MagdaNastase/Stabilizator-de-tensiune-cu-ERS/README.md

I designed and implemented a voltage stabilizer with a series regulator (ERS), ensuring a stable output voltage and overload protection. The project included simulations, PCB design, and functionality testing.
