MagdaNastase/Stabilizator-de-tensiune-cu-ERS/P1_2024_434D_Nastase_Maria-Magdalena_SERS_N17_Pspice/Proiect docs/proiect_CEF2.pdf

Facultatea de Electronică, Telecomunicații și Tehnologia Informației

## Proiect - Circuite electronice fundamentale 2

## Stabilizator de tensiune cu ERS

### Student: Năstase Maria-Magdalena

### Grupa: 434D

## CUPRINS

### 1. Date inițiale de proiectare

### 2. Schema bloc a montajului electric

### 3. Schema electrică a montajului

### 4. Simulări efectuate pentru a demonstra funcționarea schemei în parametrii impuși

### 1. Date inițiale de proiectare

Să se proiecteze și realizeze un stabilizator de tensiune cu ERS având următoarele caracteristici:

¨ Tensiunea de ieșire reglabilă în intervalul:
- 8. 5 ÷ 17 [V] pentru N=17
¨ Element de reglaj serie;
¨ Sarcina la ieșire 680[Ω];
¨ Deriva termică < 2mV/⁰C;
¨ Protecție la suprasarcină prin limitarea temperaturii tranzistorului regulator serie la120⁰C, si a curentului maxim la 0,5A;
¨ Tensiune de intrare în intervalul:
- 30,6 ÷ 34 pentru N=17
¨ Amplificarea | în | tensiune | minimă | (în | buclă | deschisă) | a
amplificatorului de eroare:minim 100;
¨ Domeniul temperaturilor de funcționare: 0

0

-60⁰C (verificabil
prin testare întemperatură);
¨ Semnalizarea prezenței tensiunilor de intrare/ieșire cu diodă de tip LED.

### 2. Schema bloc a montajului electric

Se utilizează o schemă de stabilizator cu element regulator serie (Reg) comandat de un amplificator de eroare (a) care compară tensiunea dată de referinţa de tensiune (Ref) cu tensiunea preluată de la ieşire prin reţeaua de reacţie. La acesta se adaugă un circuit de protecţie la suprasarcină(Prot)

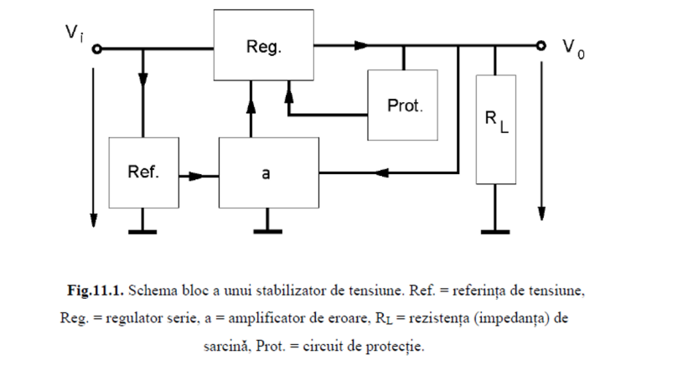
[picture p2: figure]

La intrarea neinversoare a amplificatorului de eroare se aplică tensiunea de referinţă, oferită de blocul REF. La intrarea inversoare a amplificatorului de eroare AE se aplică, prin intermediul reacţiei negative, o fracţiune din tensiunea de ieşire. Blocul de regulator serie ERS este comandat de amplificatorul de eroare care compară tensiunea dată de referinţa de tensiune REF cu tensiunea preluată de la ieşire prin reţeaua de reacţie. La acesta se adaugă un circuit de protecţie la suprasarcină Prot.

### 3. Schema electrică a montajului

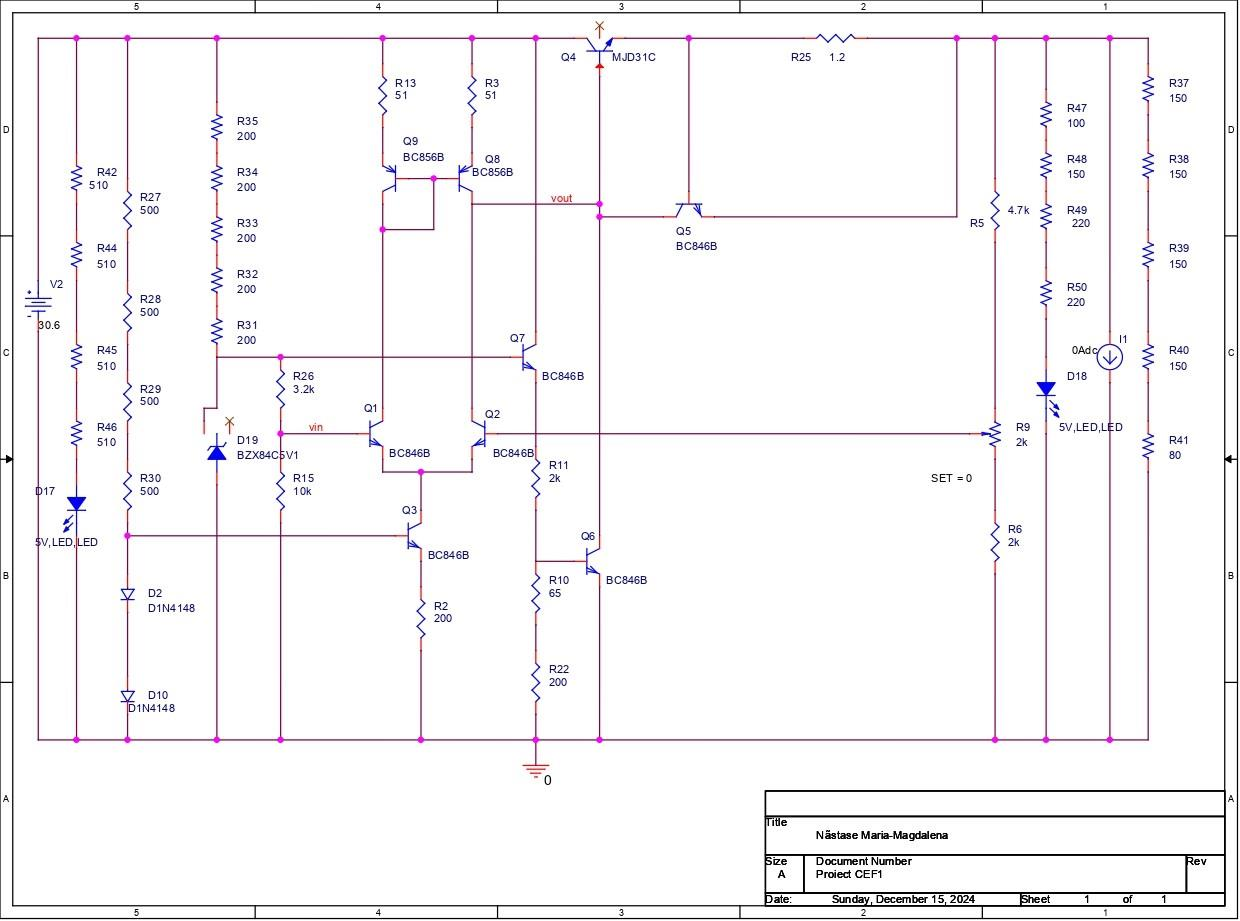
[picture p3: figure]

Stabilizatorul de tensiune este circuitul care asigură la ieșire o tensiune constantă în condițiile în care variază tensiunea de la intrare, curentul și temperatura. Pentru realizarea stabilizatoarelor de tensiune se folosesc proprietățile diodelor Zener. Cel mai simplu tip de stabilizator este stabilizatorul parametric, realizat cu o diodă Zener, însă performanțele scăzute nu îl recomandă pentru alimentarea unor circuite complexe. Tensiunea de ieșire nu poate fi reglată, ea variază în raport cu sarcina, iar curentul maxim furnizat în sarcină este relativ mic (comparabil cu curentul care trece prin dioda Zener). De aceea, s-a folosit o schemă mai complexă, un stabilizator cu reacție. Referința de tensiune pentru acesta este practic un stabilizator parametric. Însă acesta lucrează acum pe o rezistență de sarcină care nu variază, ceea ce înseamnă că se face comanda în tensiune pe o sarcină constantă.

### 1. Referința de tensiune

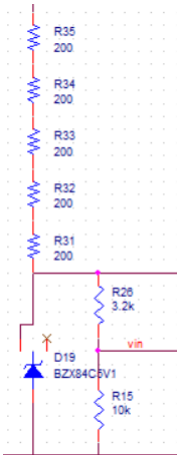
[picture p4: figure]

### Referința de tensiune din schemă este

realizată folosind o diodă Zener (D16,

### BZX84C5V1) care menține o tensiune

constantă | de | aproximativ | 5,1 | V.

### Rezistoarele R31-R36 limitează curentul

prin | diodă, | asigurând | stabilitatea

### funcționării. Această referință de tensiune este utilizată pentru a seta un punct de

operare stabil în circuit.

### 2. AMPLIFICATOR DE EROARE

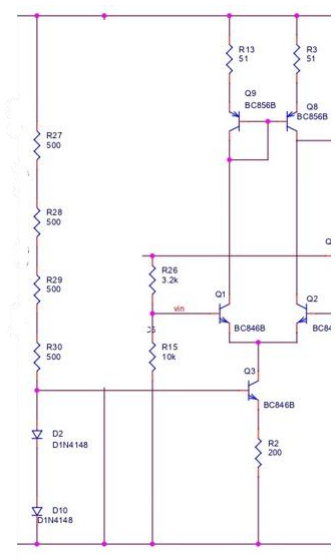
[picture p5: figure]

Generatorul de curent constant format din Q3, R2, D2, D10, vrea să tragă din amplificator un curent de aproximativ 4 mA, iar tranzistorul Q3 să funcționeze în RAN.

IC1 + IC2 = I, dar

VBE3 +R2*I=2VD

Rezultă R2=200Ω. Se aleg tranzistoarele Q1, Q2, Q3 de tip BC846B. Pentru echilibrul curenților din colectori IC1 și IC2, folosim oglinda de curent formată din Q8 și Q9 de tipul BC856B. Rezistorii R13 si R3 au rolul de a egaliza tensiunile baza-emitor a tranzistorilor din oglinda de curent realizata cu Q1 si Q2, de aceea R13 = R3 =51Ω

### 3. ELEMENTUL DE REGLAJ SERIE

### Am ales ca element regulator serie, un transistor de tip

MJD31CG SMD, NPN, 100V,
15W, | 3A. | În | cel | mai

### nefavorabil caz acesta va

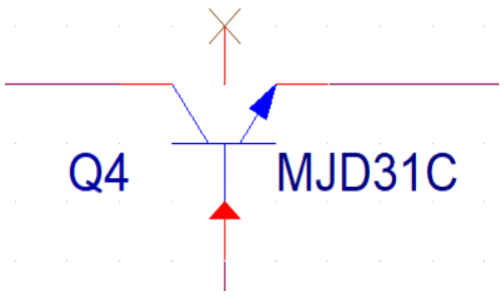
[picture p6: figure]

### suporta un curent de 0.5 mA și o tensiune de 10 V, P=U*I=> puterea maximă ce se va disipa pe acest transistor va fi 0.5mA*10 V = 5W. Caracteristicile acestui transistor ne asigură funcționarea elementului regulator serie fară pericolul

supradisiparii. ERS-reprezinta cea mai importanta componenta, deoarece face trecerea intre tensiunea de intrare si cea de iesire, acesta controleaza starea stabilizatorului.

### 4. RETEAUA DE REACTIE NEGATIVA

Aceasta este un simplu divizor de tensiune.

### Tensiunea eșantionată de aceasta este comparată cu tensiunea de referință dată de dioda Zener divizată:

Unde R9 modelează un pontențiometru . Pentru a regla tensiunea la ieșire între 8.5V și 17V folosim un pontentiometru de 2kΩ. Aleg rezistențele astfel încât să obțin la ieșire un interval de tenisuni în care este inclus și intervalul impus de cerință. In urma calculelor am aflat cele 2 necunoscute R5 si R6=> R5=4.7kΩ și R6=2kΩ

### 5. CIRCUITUL DE PROTECTIE

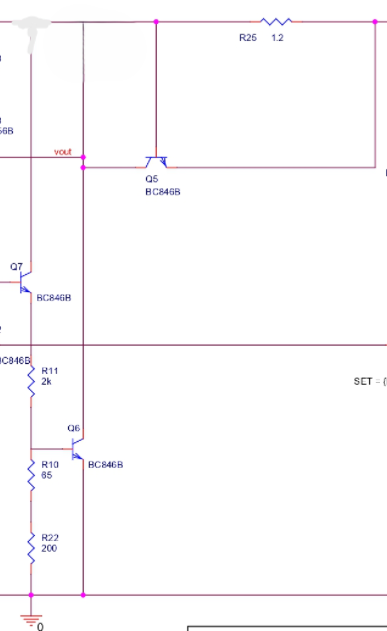
[picture p7: figure]

Senzorul | de | temperatură | este
tranzistorul Q6 împreună elementele ajutătoare Q7 și divizorul rezistiv format din R11 , R10 și R22. Senzorul de supracurent este tranzistorul Q5 împreună cu rezistenta R25, lucreaza ca un convertor de curent-tensiune. Tranzistorul Q5 se montează cuplat termic cu tranzistorul Q6 si Q4 (element regulator serie). Odată cu
creșterea | temperaturii | scade | și
tensiunea | de | deschidere | a
tranzistorului, astfel încât la o anumită temperatură acesta se deschide și creste curentul său de colector.

### 2.4 Punctul static de functionare: tensiune, curenti, putere Pentru a simula punctul static de funcționare se va ține cont de

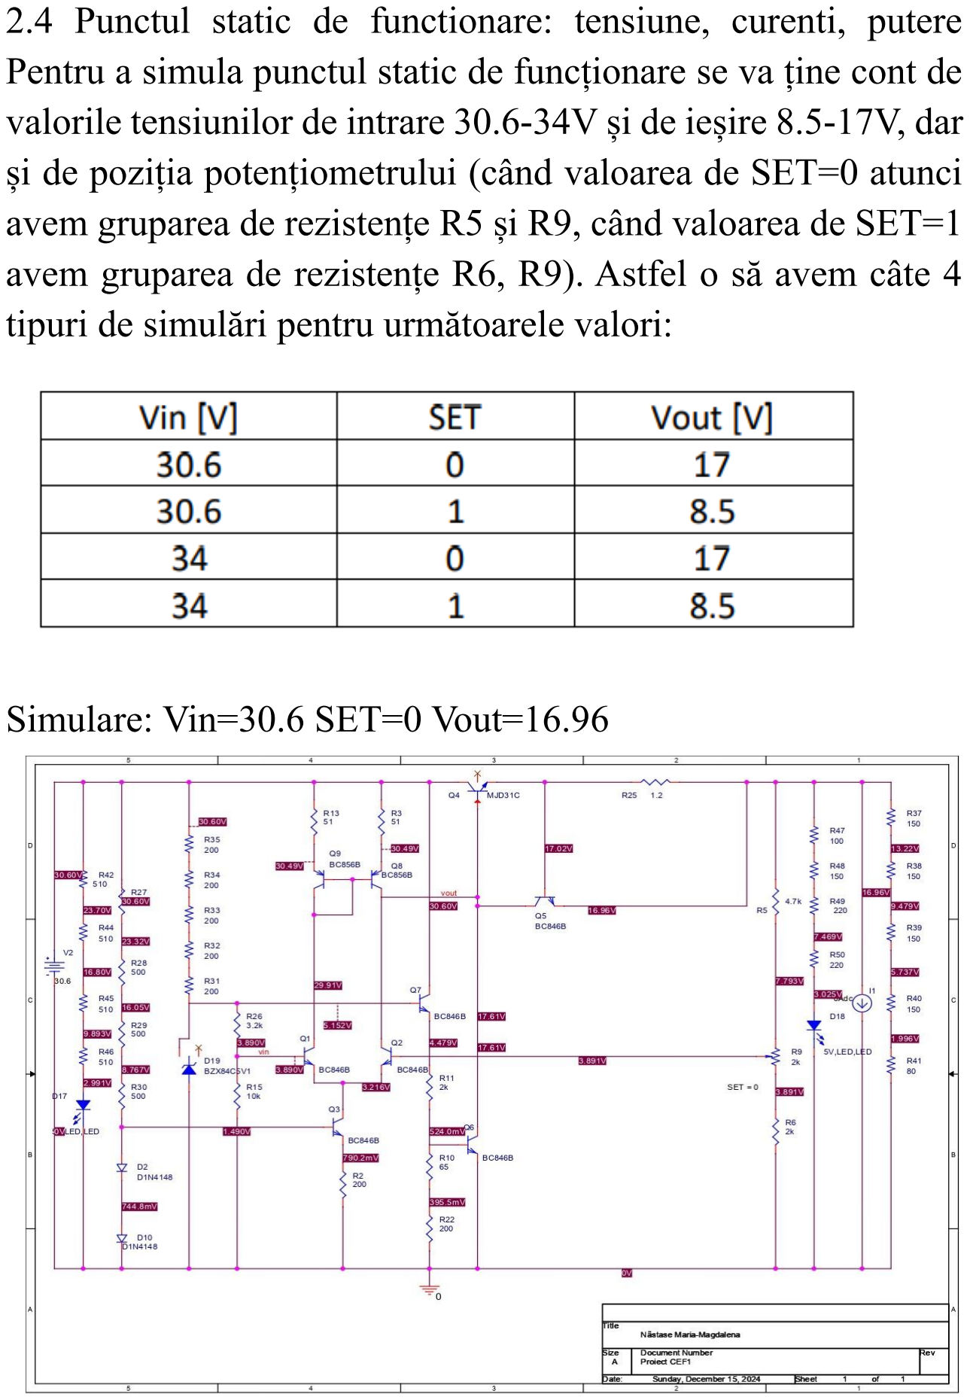
[picture p8: page 11]

### valorile tensiunilor de intrare 30.6-34V și de ieșire 8.5-17V, dar și de poziția potențiometrului (când valoarea de SET=0 atunci avem gruparea de rezistențe R5 și R9, când valoarea de SET=1 avem gruparea de rezistențe R6, R9). Astfel o să avem câte 4 tipuri de simulări pentru următoarele valori:

### Simulare: Vin=30.6 SET=0 Vout=16.96

### Simulare: Vin=30.6 SET=1 Vout=8.507

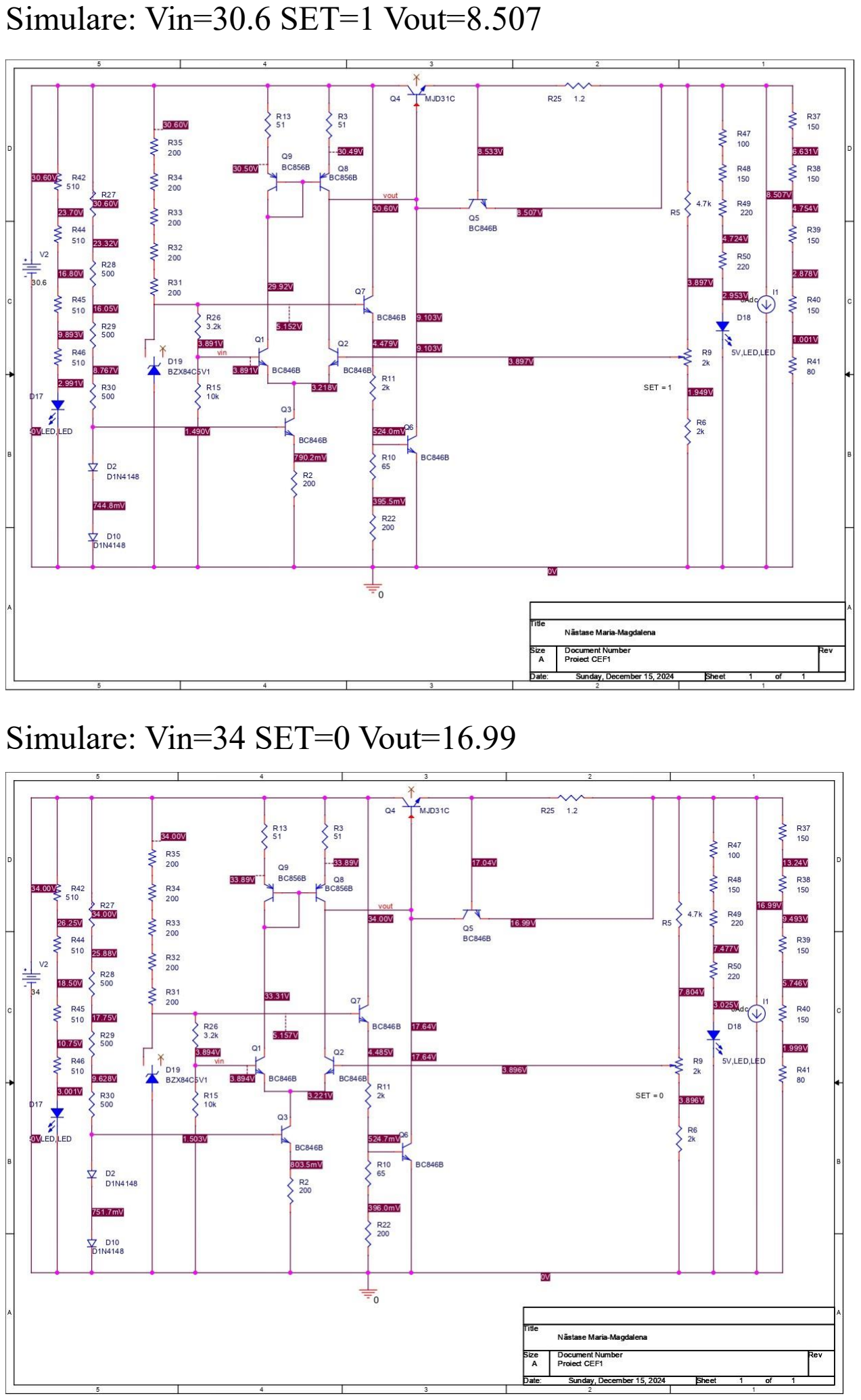
[picture p9: page 12]

### Simulare: Vin=34 SET=0 Vout=16.99

### Simulare: Vin=34 SET=1 Vout=8.52

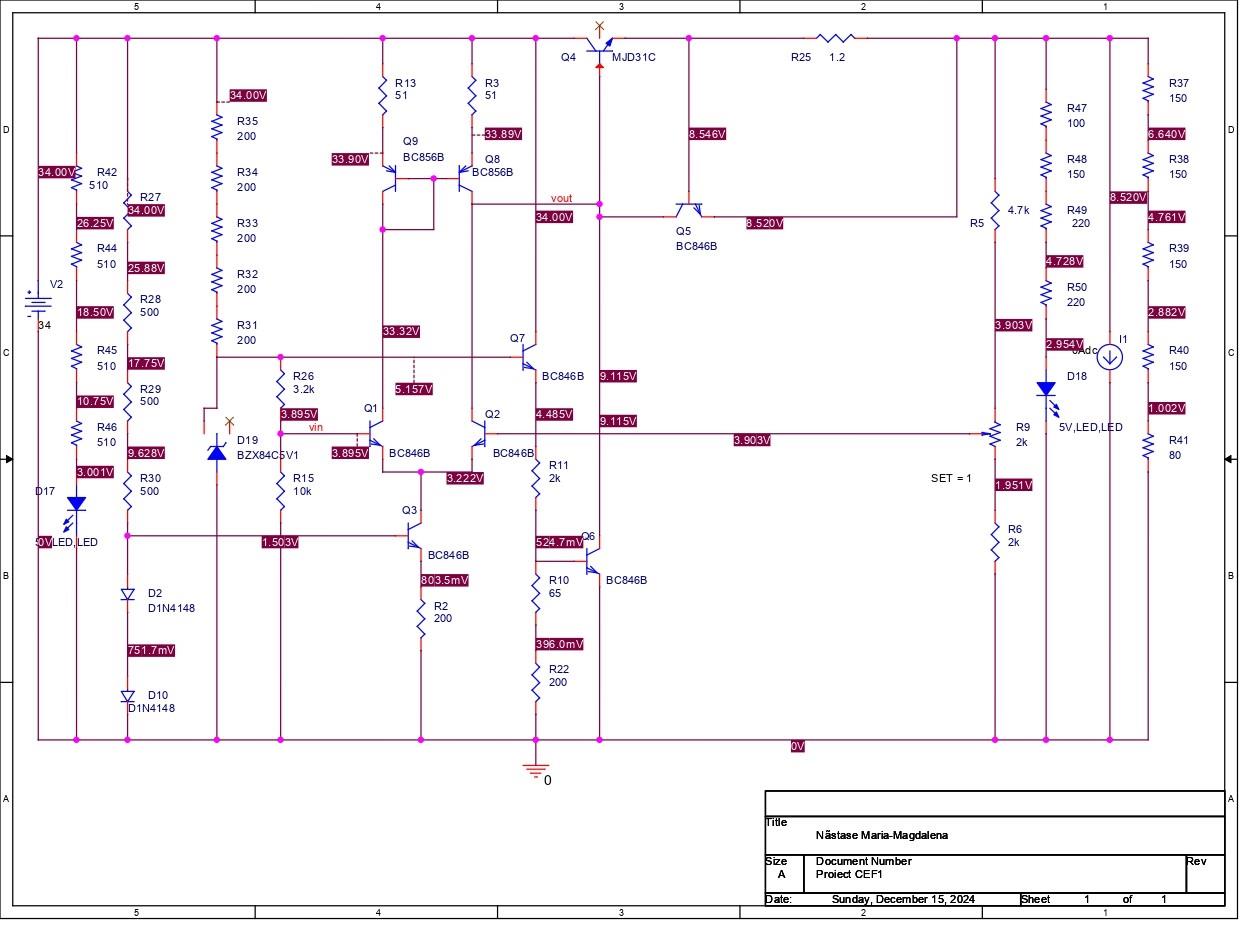
[picture p10: figure]

### *PSF-CURENTI

### Simulare: Vin=30.6 SET=0 Vout=16.96

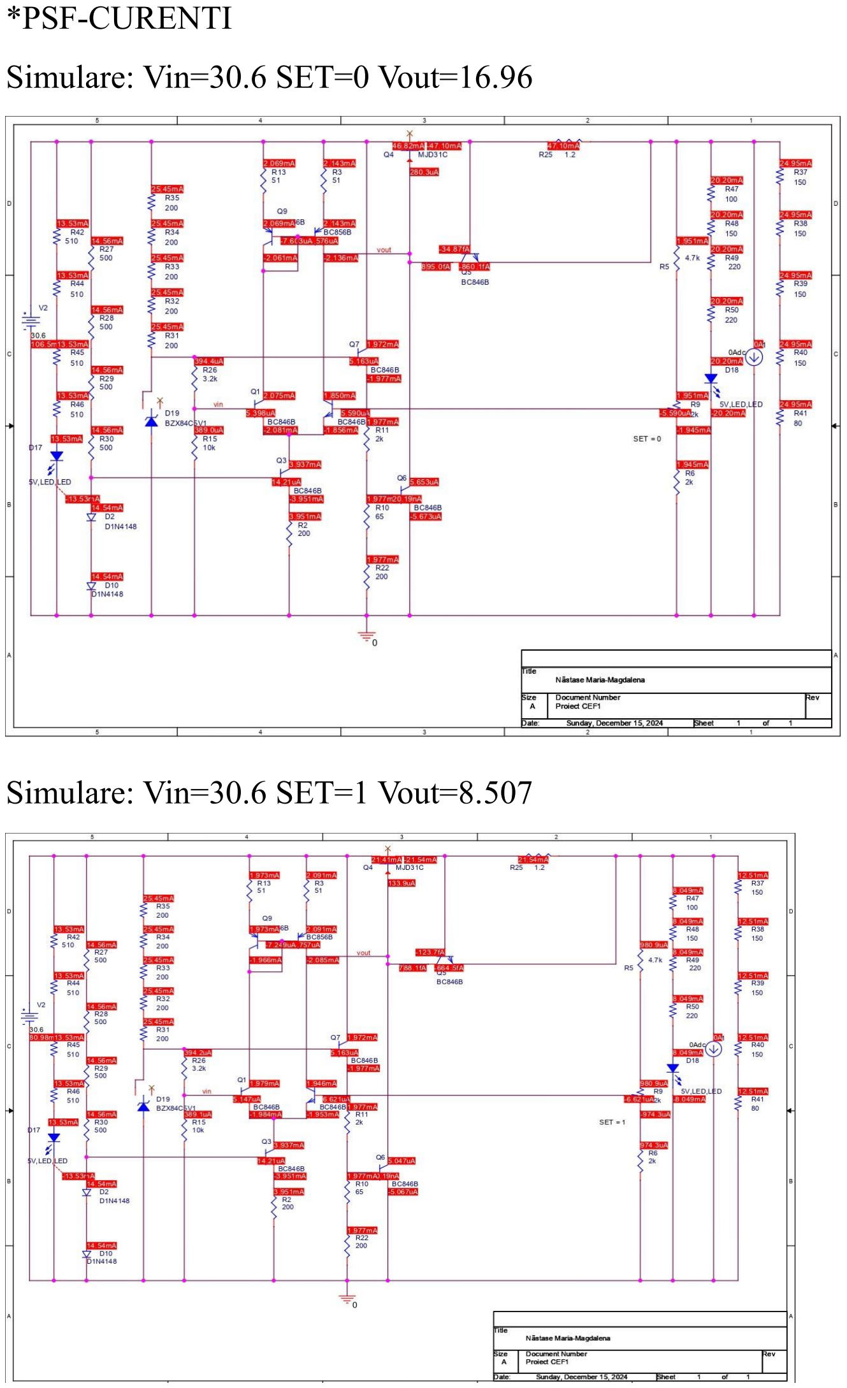
[picture p11: page 14]

### Simulare: Vin=30.6 SET=1 Vout=8.507

### Simulare: Vin=34 SET=0 Vout=16.99

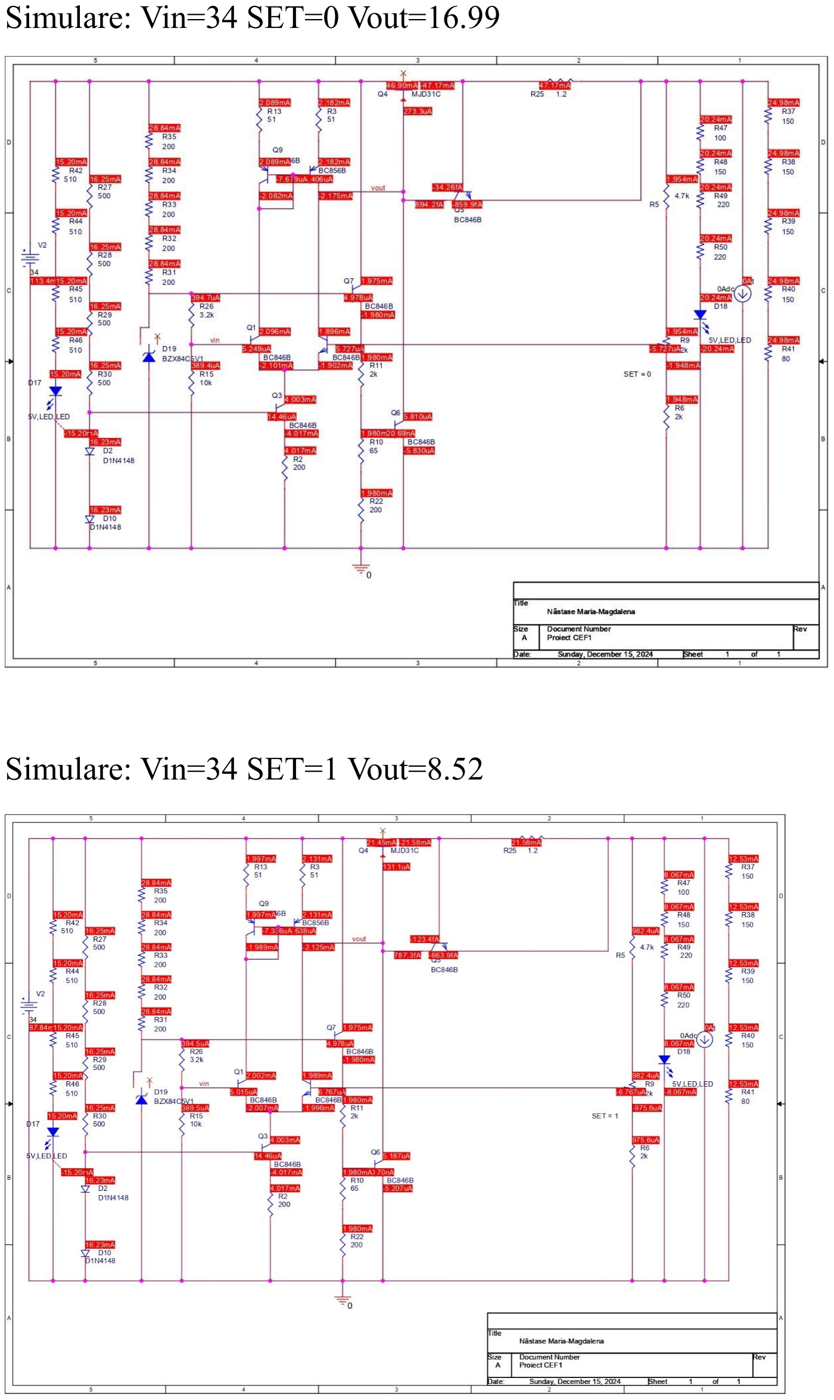
[picture p12: page 15]

### Simulare: Vin=34 SET=1 Vout=8.52

### *PSF- PUTERI

### Simulare: Vin=30.6 SET=0 Vout=16.96

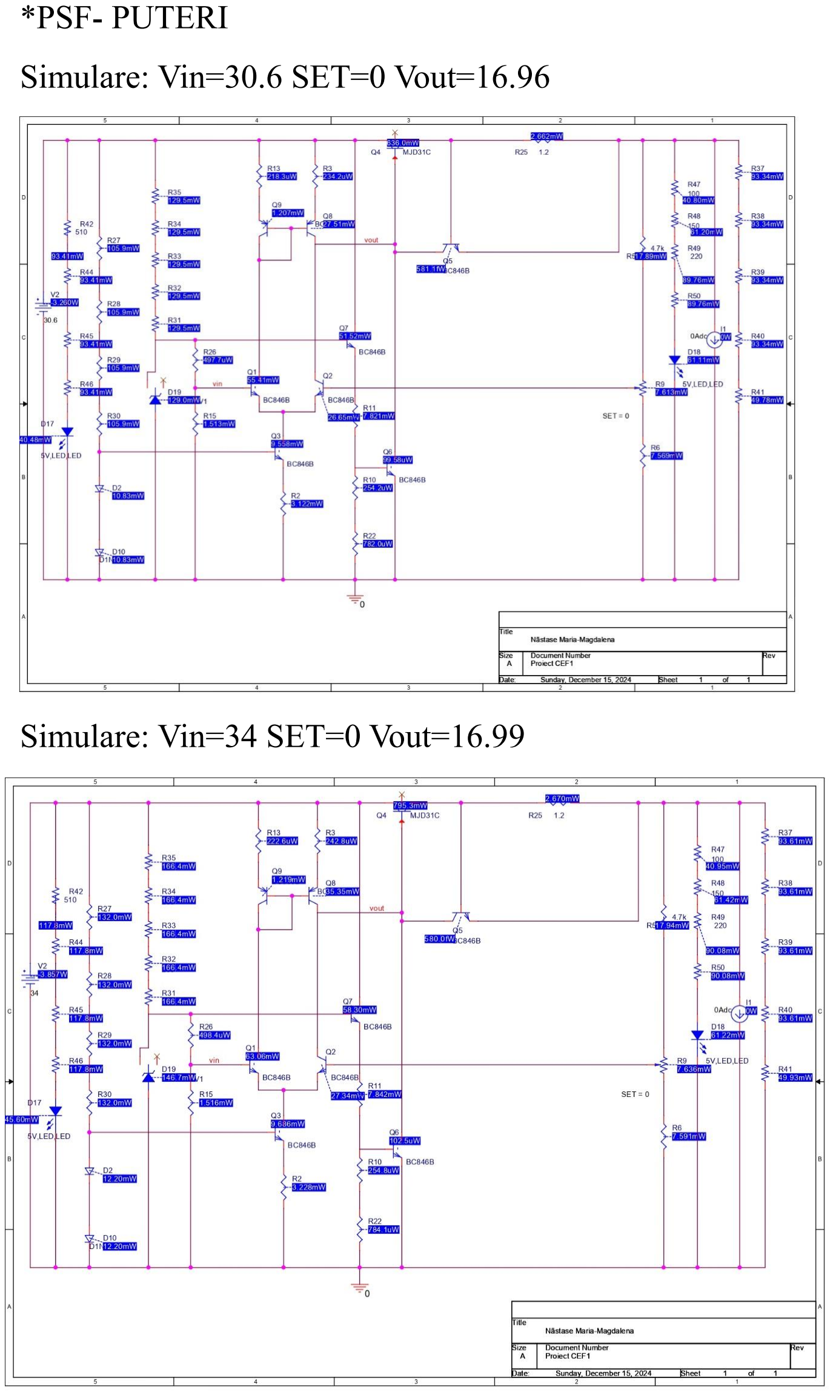
[picture p13: page 16]

### Simulare: Vin=34 SET=0 Vout=16.99

### Simulări

### Protecția la temperatură

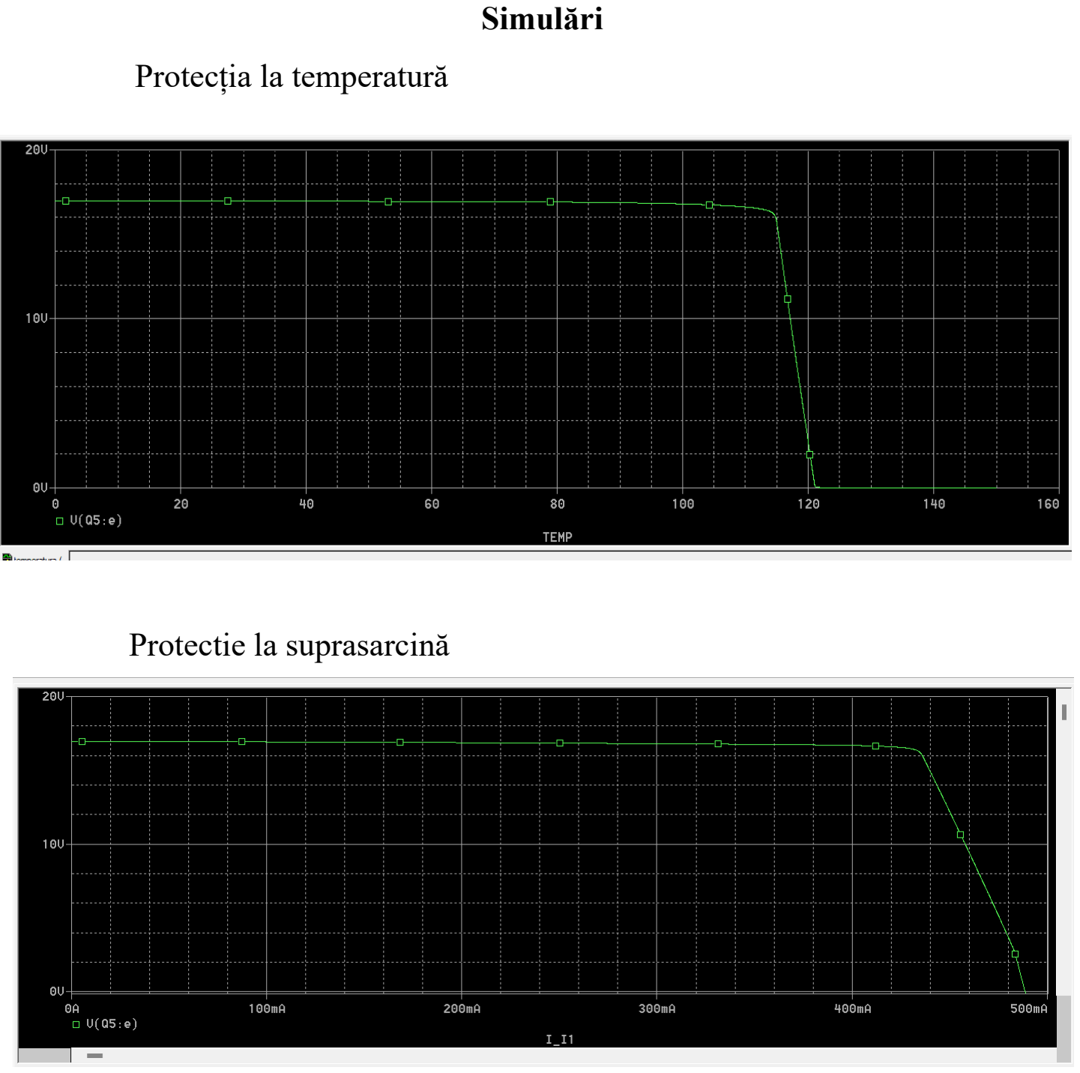
[picture p14: page 17]

### Protectie la suprasarcină

### Variația tensiunii de ieșire în funcție de variația tensiunii de intrare

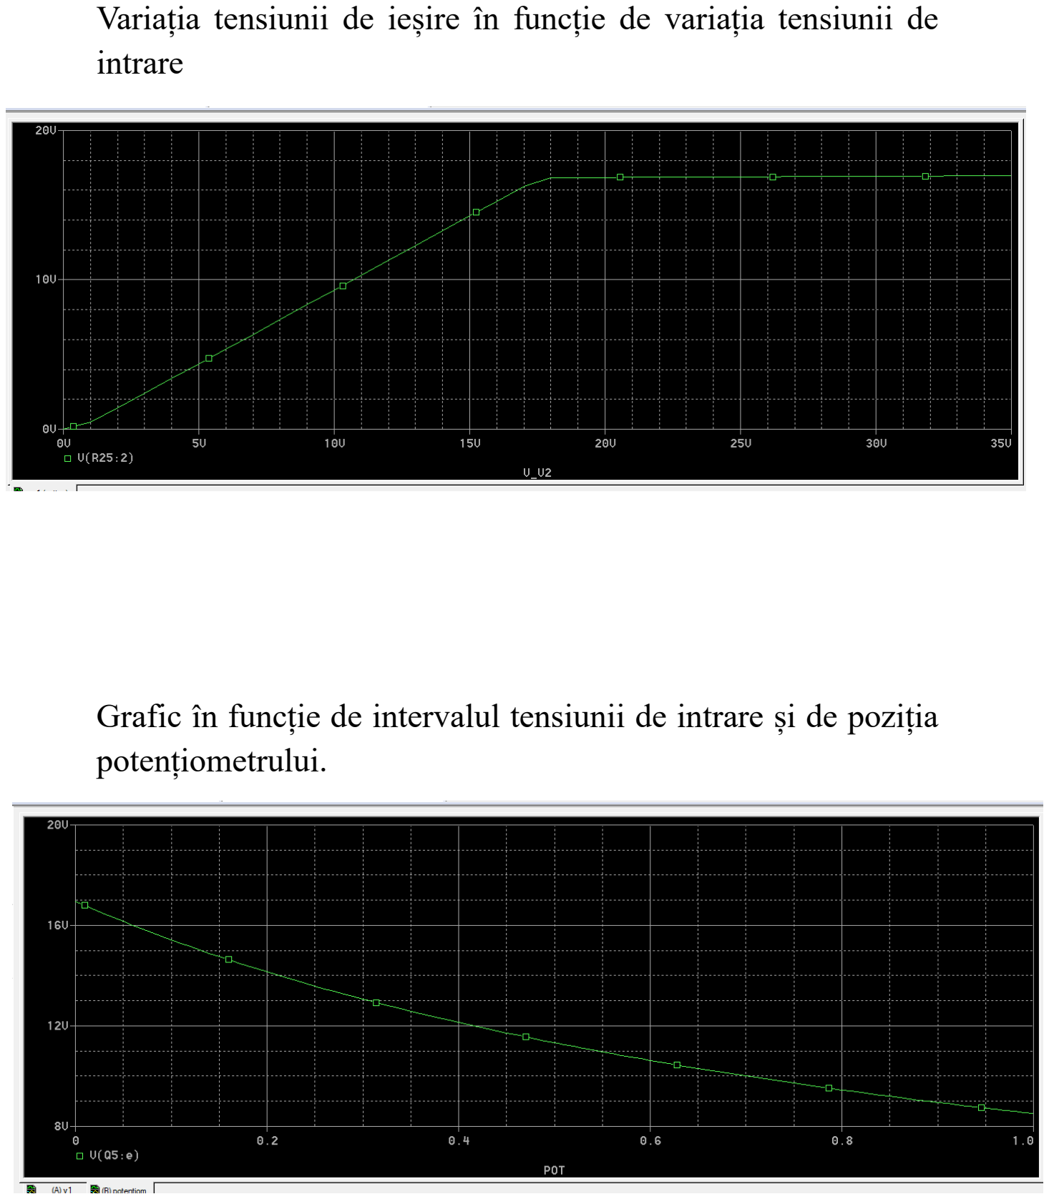
[picture p15: page 18]

### Grafic în funcție de intervalul tensiunii de intrare și de poziția

potențiometrului.

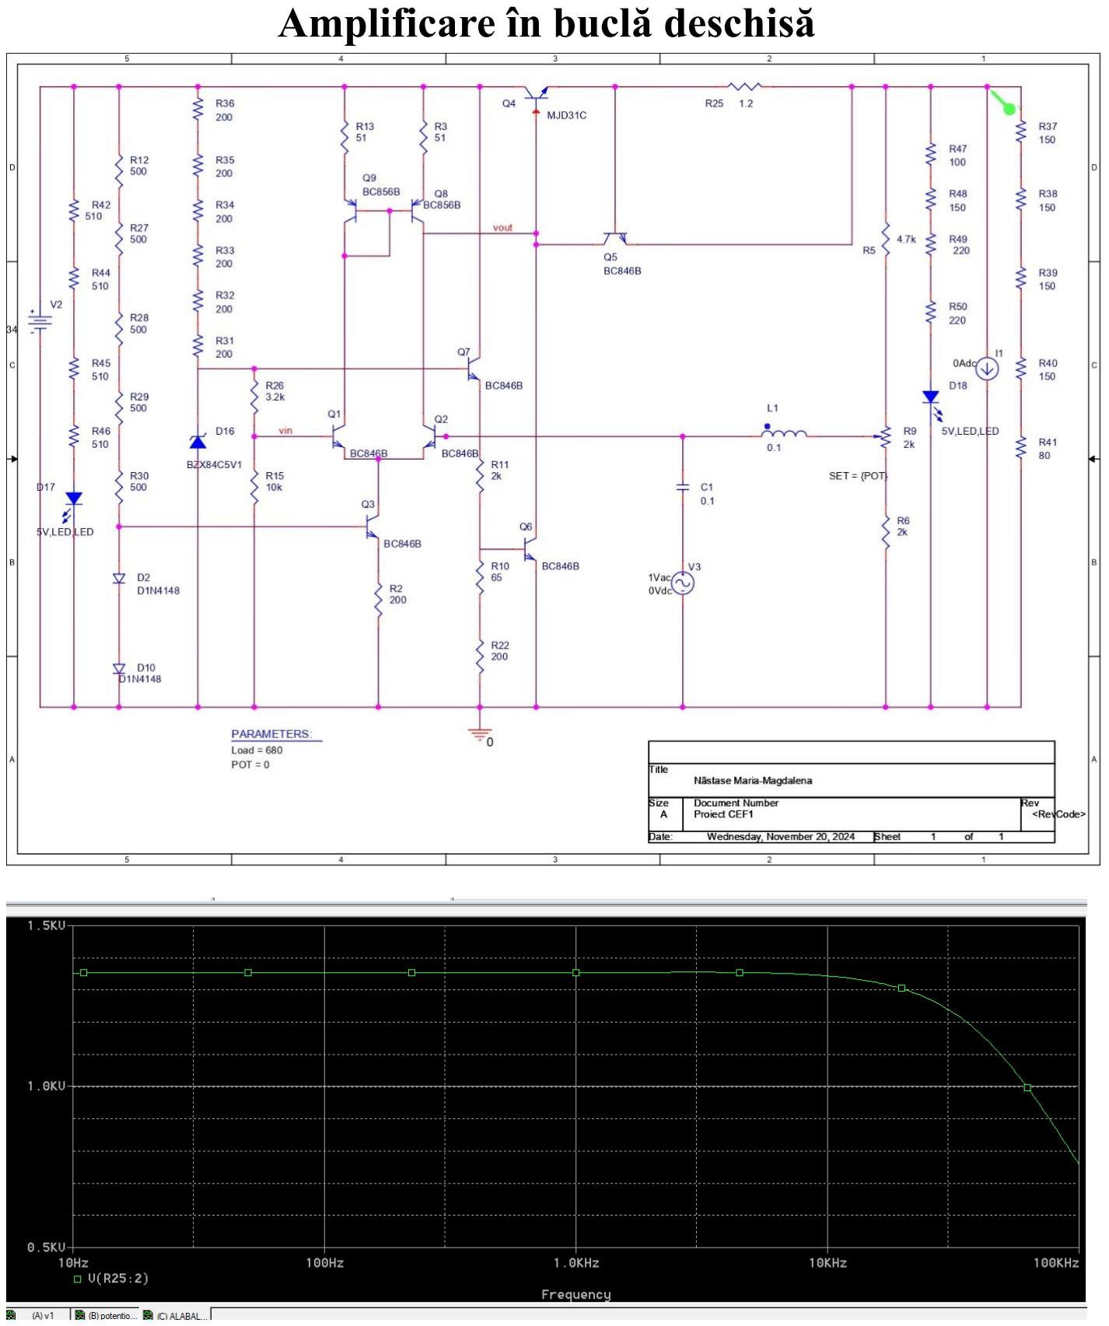
[picture p16: page 19]

### Amplificare în buclă deschisă
