MagdaNastase/Stabilizator-de-tensiune-cu-ERS/P1_2024_434D_Nastase_Maria-Magdalena_SERS_N17_Pspice/Simulations/temperatura.jpg

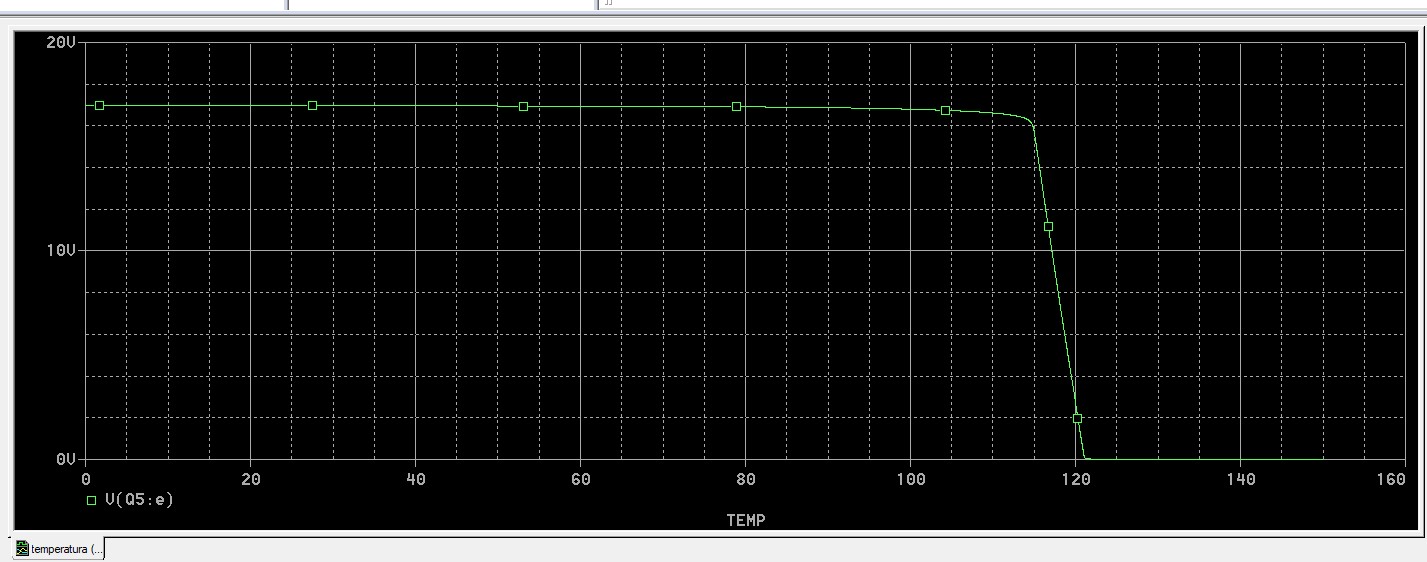
P1_2024_434D_Nastase_Maria-Magdalena_SERS_N17_Pspice/Simulations/temperatura.jpg
