MagdaNastase/Stabilizator-de-tensiune-cu-ERS/(list of files, drawings)

Other design files:
P1_2024_434D_Nastase_Maria-Magdalena_SERS_N17_Pspice/Schematics/PROIECT_CEF.DSN
P1_2024_434D_Nastase_Maria-Magdalena_SERS_N17_Pspice/Schematics/proiect_cef.opj
